finnhittson/FM-Radio-Final-Project/lab3/EE251 Lab 3, Finn & Zack.pdf

## EE251 Lab 3

Authors: Finn Hittson & Zack Seifert Date: 02.04.2026

Oscillator and Mixer Result

Conversion Gain (-23 dBm RF input) | Mixer output bandwidth
-13 dBm at 10.7 MHz | ~250 KHz
| 10.7 MHz | 88 MHz | 98 MHz | 108 Mhz
S11 (dB) | NA | -15.2 | -18.8 | -16.3
S22 (dB) | -13.4 | NA | NA | NA

Oscillator and Mixer Schematic

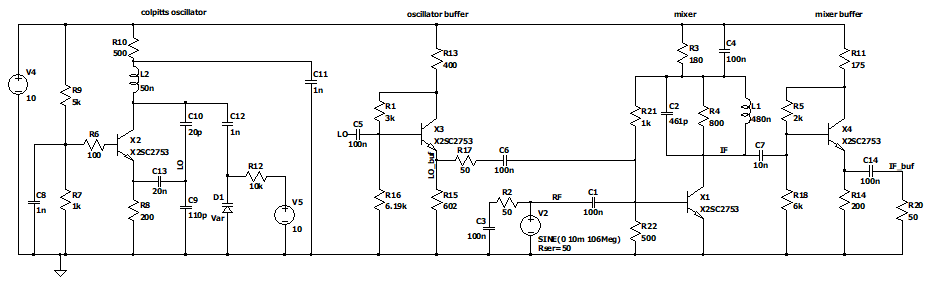
[picture p13: figure]

Physical Board

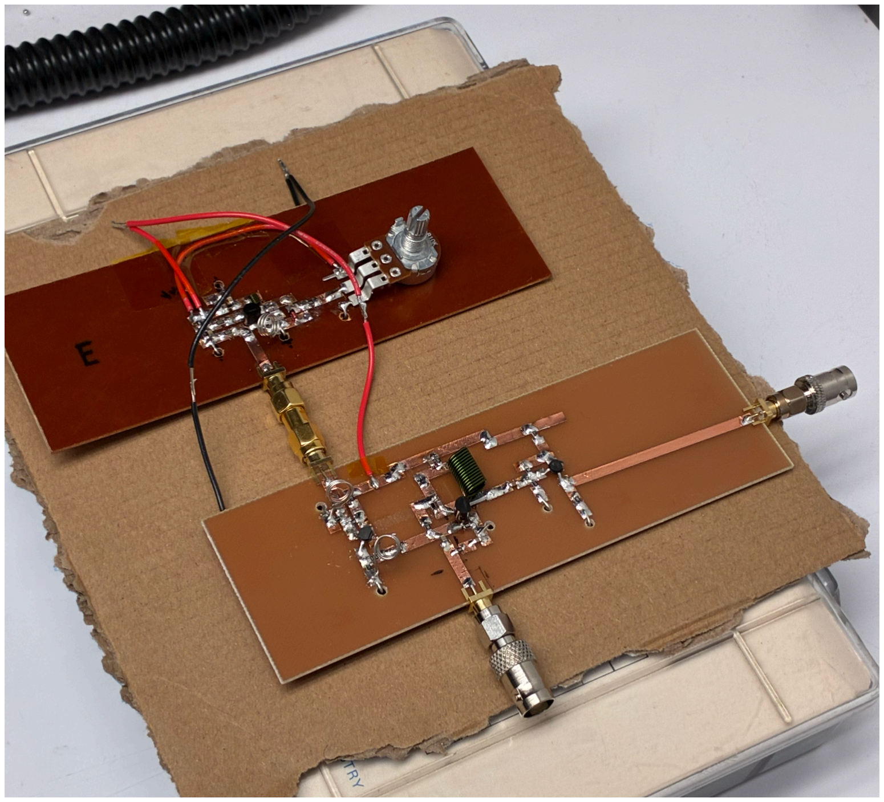
[picture p14: figure]

Technical Discussion

Local Oscillator (LO):
For the LO we opted for a Colpitts design using a varactor for frequency tuning. The desired tuning range is from 98.7 to 118.7 MHz. To achieve this range we first chose our inductor to be 50nH. The resonant frequency of the Colpitts is computed with the following equation.
ω0 =

1
LC
eq
C is the equivalent capacitance of the oscillator. Typically the oscillator has a capacitor divider
eq
network so C | . However since we need to make the oscillator tunable we introduce a
eq = C
1

‖ C
2
varactor in parallel to the capacitor divider network. Thus the equivalent capacitance is
C | . In the schematic the varactor is in series with a 1nF capacitor. This is to
eq = C
1

‖ C

2 + C
var
block the bias voltage from the oscillator. The blocking capacitor is magnitudes larger than the varactor so their series value will be dominated by the varactor since it is smaller.
We used a 1N5248 zener diode to act as our variable capacitor. It ranges from 18pF to 36pF with a 1V to 10V bias swing. With this bound we iteratively computed C . First we let be
1

C
2

110pF. We are shooting for a C | ratio of about 4 and we found that this value for | works
2

/C
1

C
2
reasonably well. Then we varied C such that the upper and lower bound roughly matched the
1
desired tuning range. We found that C | gives us the desired range.
1 = 20pF
Computing the lower frequency bound is the following.
C

eq =

1
ω0

2
L

=

1
(2πf
0

)

2
L

=

1
(2π · 98.7MHz)

2
- 50nH

= 52. 7pF

C

var = C

eq − C
1

‖ C

2 = 52. 7pF − 20pF ‖ 110pF = 35. 8pF
Since C | is less than the maximum value for the varactor, the current values for | and
var

C
1

C
2
satisfy the lower frequency bound. Computing the upper frequency bound is the following. C

eq =

1
(2π · 118.7MHz)

2
- 50nH

= 35. 2pF

C

var = C

eq − C
1

‖ C

2 = 35. 2pF − 20pF ‖ 110pF = 18. 3pF
Since C | is more than the minimum value for the varactor, the current values for | and
var

C
1

C
2
satisfy the upper frequency bound.

Mixer:
Initially we chose a mixer configuration that fed the RF to the base and the LO to the emitter. Our main motivation was that this would provide better isolation for the oscillator from the RF injection. However, we were not able to get enough conversion gain, so we opted to connect both the RF and LO at the base. This helped to increase our conversion gain because of the ease in matching at the base as opposed to the emitter. Ultimately more of the LO signal is passed through which creates stronger mixing products.
The mixer is essentially a narrow band amplifier. The resonant frequency of the tank needs to be 10.7MHz. For high conversion gain and high Q we iteratively found that L = 480nH. Then using the resonant frequency we can calculate the tank’s capacitor.
C =

1
ω0

2
L

=

1
(2π · 10.7MHz)

2
- 480nH

≈ 460pF

For high Q we iteratively found that a tank resistance of 800Ω worked well. Above the tank is a current limiting resistor with an AC bypass.

LO and Mixer Buffer:
Between the LO and the mixer and the mixer to the output is a buffer. We use buffers to provide extra isolation between the buffer and the mixer and the mixer to the output. They are also convenient for impedance matching. The buffers are biased to present the input with a high impedance so that it will load it and change its behavior. In addition it also has a low output impedance which is useful for 50Ω output impedance matching for the next stage.

Mixer Output Spectrum Analyzer Plot (RF Input: -31.56dbm)

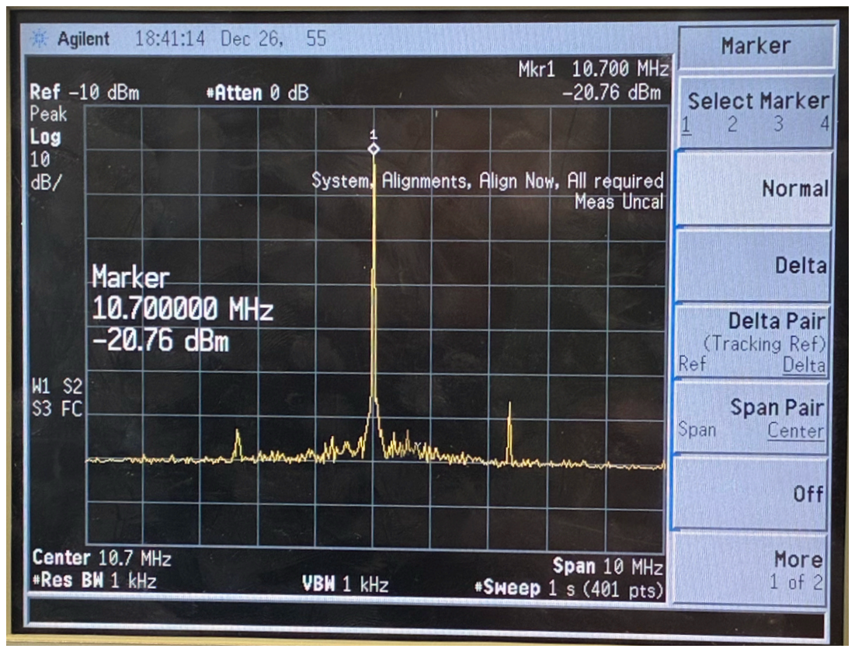
[picture p15: figure]

RF Input Spectrum Analyzer Plot

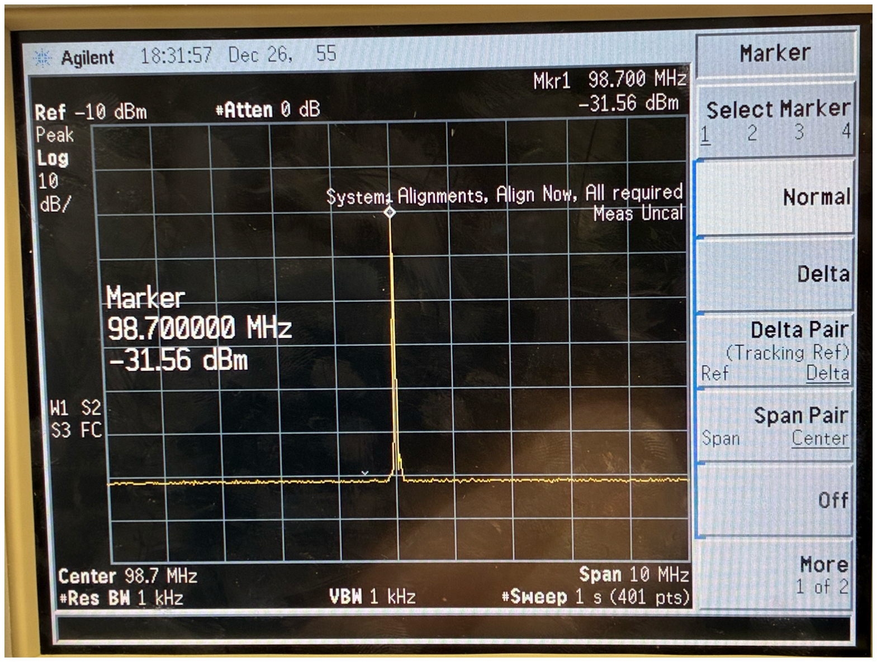
[picture p16: figure]

Mixer RF Input VNA S11 Plot

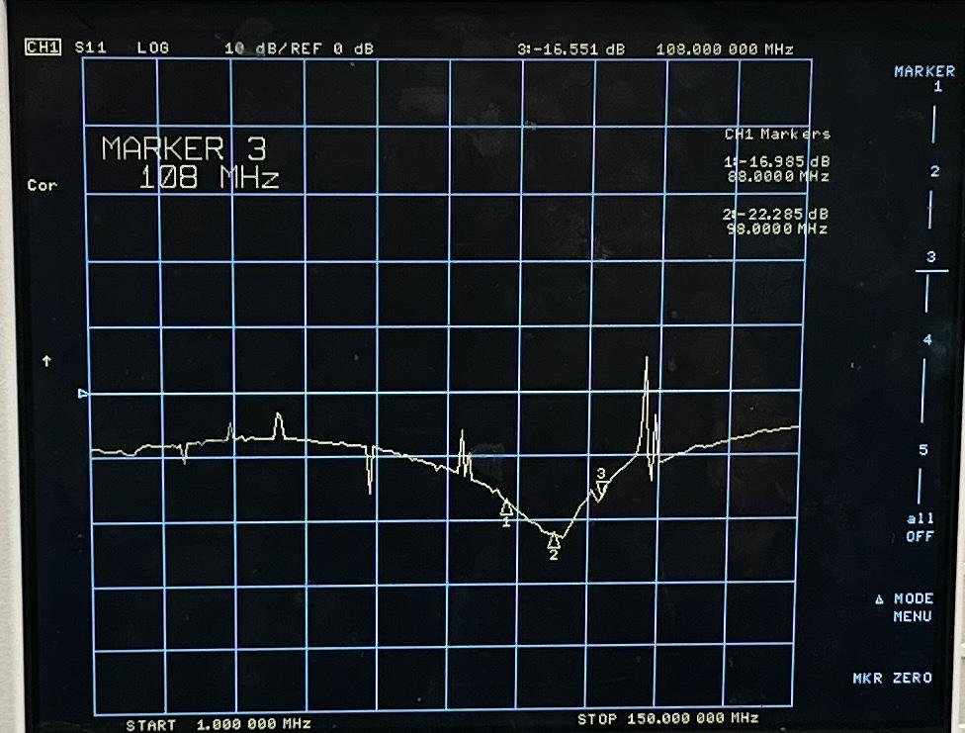
[picture p17: figure]

Mixer RF Output VNA S11 Plot

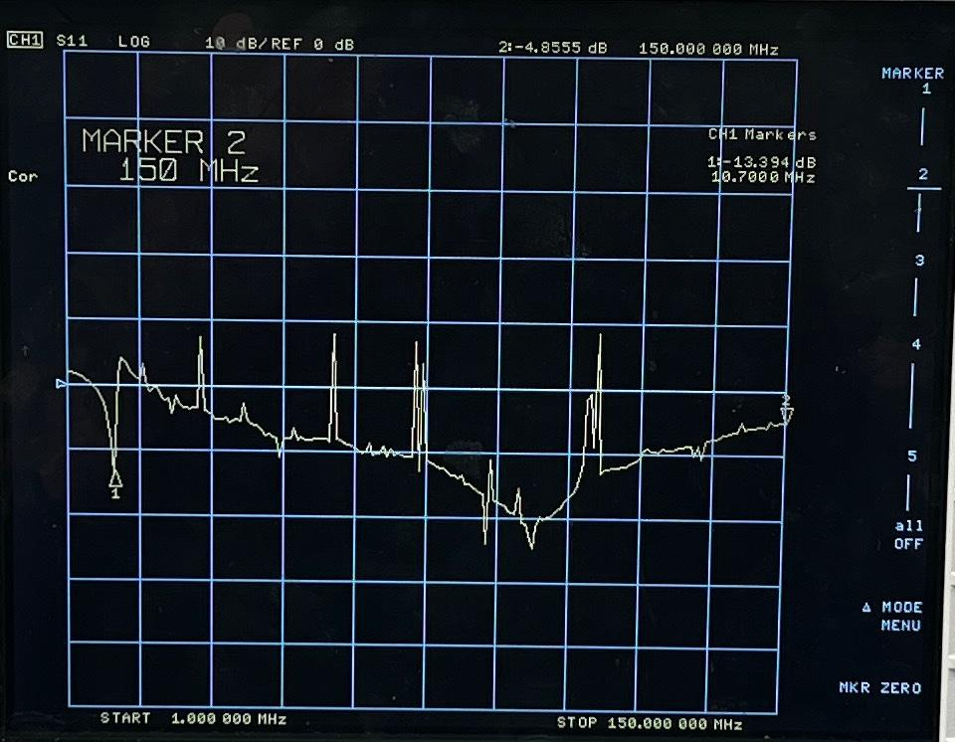
[picture p18: figure]
