finnhittson/FM-Radio-Final-Project/images/broadband.png

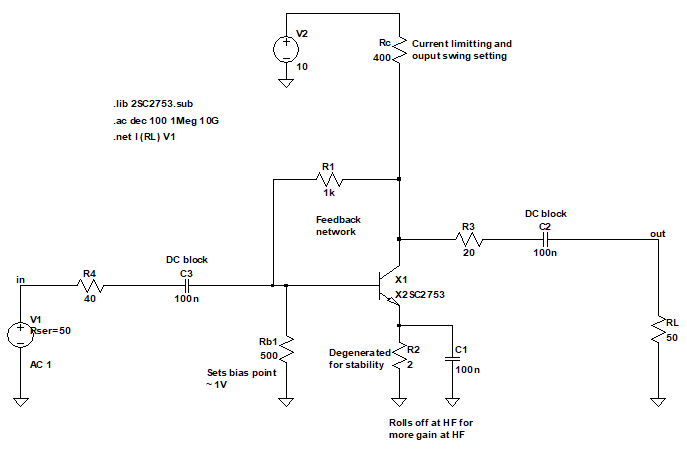
images/broadband.png
