finnhittson/FM-Radio-Final-Project/images/narrowband.png

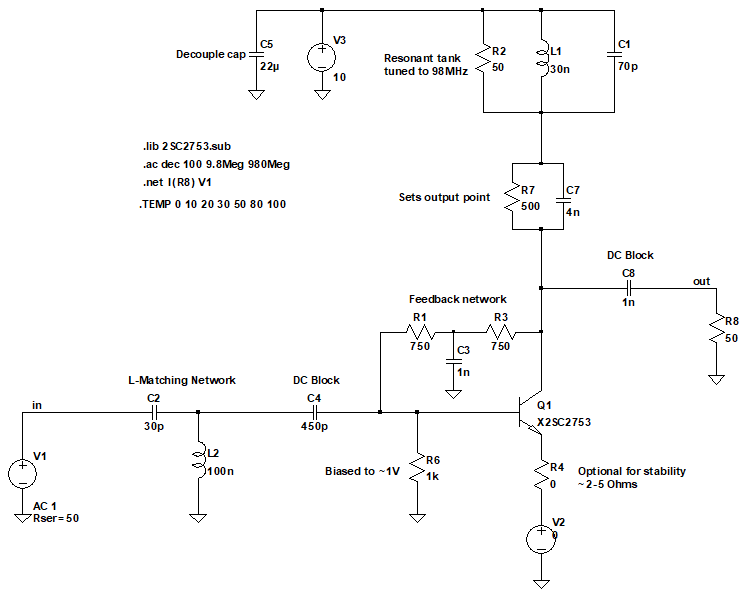
images/narrowband.png
