finnhittson/FM-Radio-Final-Project/lab2/broadband/broadband.asc

C1: cap; 100n
C2: cap; 100n
C3: cap; 100n
R1: res; 1k
R2: res; 2
R3: res; 20
R4: res; 40
Rb1: res; 500
Rc: res; 400
RL: res; 50
V1: voltage; ""; AC 1; Rser=50
V2: voltage; 10
X1: npn; X2SC2753
Named nets: 0, out, in
.lib 2SC2753.sub
.ac dec 100 1Meg 10G
.net I(RL) V1
DC block
DC block
Degenerated
for stability
Rolls off at HF for 
more gain at HF
Current limitting and 
ouput swing setting
Feedback
network
Sets bias point
~1V
