finnhittson/FM-Radio-Final-Project/lab3/mixer-oscillator/mixer-oscillator.asc

10p: cap; 40p
C1: cap; 100n
C2: Cap; 461p
C3: Cap; 100n
C4: cap; 100n
C5: cap; 100n
C6: cap; 100n
C7: cap; 10n
C8: cap; 1n
C9: cap; 18p
C10: cap; 4p
C11: cap; 1n
C12: cap; 1n
C13: cap; 100n
C14: cap; 100n
L1: ind; 480n
L2: ind; 100n
R1: res; 3k
R2: res; 50
R3: res; 180
R4: res; 800
R5: res; 2k
R6: res; 100
R7: res; 1k
R8: res; 1k
R9: res; 5k
R11: res; 175
R12: res; 100k
R13: res; 400
R14: res; 200
R15: res; 602
R16: res; 6.19k
R17: res; 50
R18: res; 6k
R19: res; 1k
R20: res; 50
R21: res; 1k
R22: res; 500
V2: voltage; SINE(0 10m 106Meg); Rser=50
V4: voltage; 10
V5: voltage; 10
X1: npn; X2SC2753
X2: npn; X2SC2753
X3: npn; X2SC2753
X4: npn; X2SC2753
Named nets: 0, LO, IF, IF_buf, RF, LO_buf
.tran 0 20.025u 20u
.include 2sc2753.sub
.MODEL BBY40 D IS=7.417E-15 N=1.058 RS=.1259 XTI=3 
+      EG=1.11 CJO=64.39E-12 M=1.013 VJ=2.566 FC=.5 BV=45.12 
+      IBV=.1232 TT=215E-9
+      ISR=1.731E-12 NR=2.27 IKF 9.882
;.ac oct 100 10Meg 1Gig
;.net I(RL) V2
gain: change bias, resonance tank
colpitts oscillator
oscillator buffer
mixer
mixer buffer
.meas tran T1 find time when V(LO)=0.9 rise 1
.meas tran T2 find time when V(LO)=0.9 rise 2
.meas tran Frequency param 1/(T2-T1)/1e6
