finnhittson/FM-Radio-Final-Project/lab4/demod/demod.asc

C1: cap; 3.2n
C2: cap; 10n
C3: cap; 100n
D1: diode
R1: res; 10k
R2: res; 8
R3: res; 59k
R4: res; 2.49k
V1: voltage; ""; AC 1
V2: voltage; 10
Named nets: 0
.ac oct 100 1k 100Meg
