finnhittson/FM-Radio-Final-Project/lab3/oscillator/oscillator.asc

C1: cap; 1n
C2: cap; 10p
C3: cap; 1n
C7: cap; 100p
C8: cap; 10p
C10: cap; 1n
C11: cap; 1n
D2: varactor; BBY40
L1: ind; 100n
R1: res; 100
R4: res; 10k
R8: res; 100
R9: res; 1.1k
R10: res; 5k
R11: res; 500
V1: voltage; 10
V5: voltage; 3
X2: npn; X2SC2753
Named nets: 0, out1
.include 2SC2753.sub
.tran 1u
.MODEL BBY40 D IS=7.417E-15 N=1.058 RS=.1259 XTI=3 
+      EG=1.11 CJO=64.39E-12 M=1.013 VJ=2.566 FC=.5 BV=45.12 
+      IBV=.1232 TT=215E-9
+      ISR=1.731E-12 NR=2.27 IKF 9.882
